riscfruit/Pico2-Expansion-Card/README.md

# FramePico2-Expansion-Card
An expansion card for Framework laptops and any other hardware, based on RP2354

### Gallery
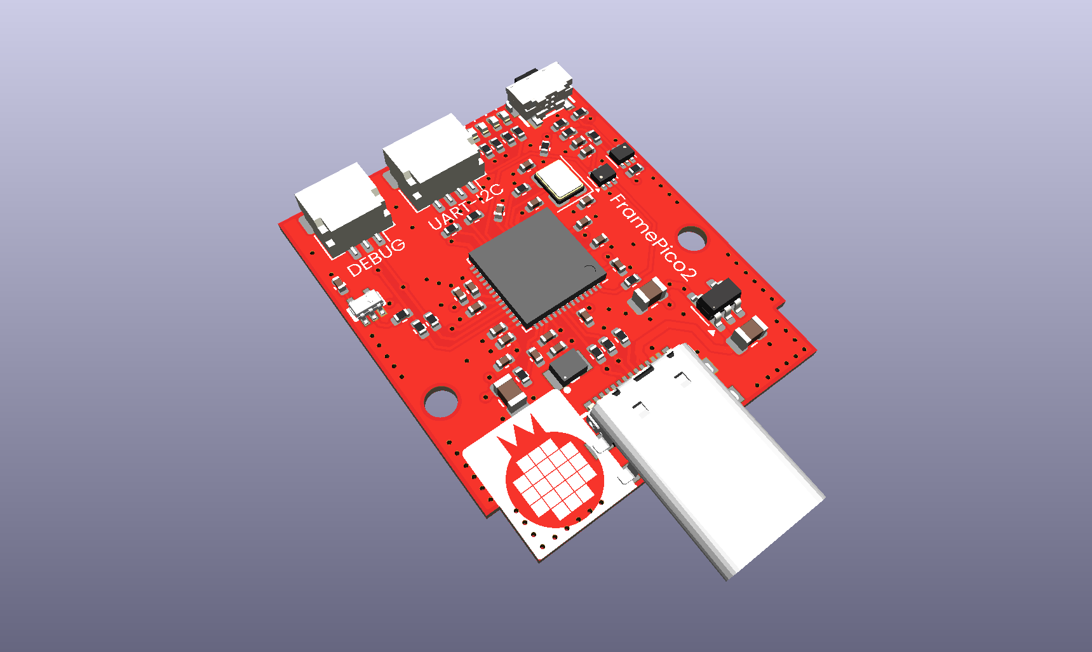
[picture p1: images/pico2-expansion-card-front.png]
Front

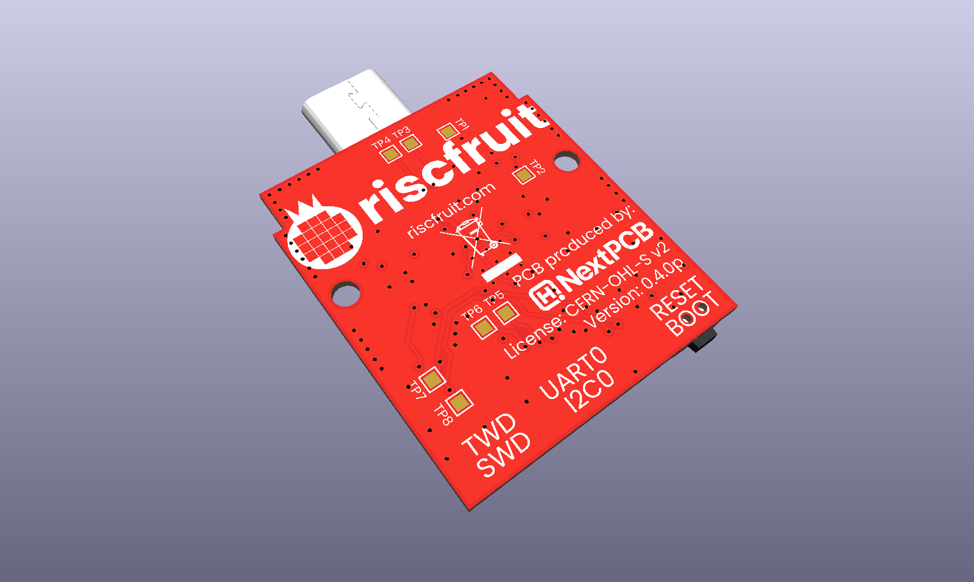
[picture p2: images/pico2-expansion-card-back.png]
Back
