riscfruit/Pico2-Expansion-Card/pcb/production/bom.csv

Designator | Package / Footprint | Qty | Value | LCSC Part # | MPN
C1, C20, C3, C5 | 402 | 4 | 4.7uF | C23733 | CL05A475MP5NRNC (Samsung)
C10, C11, C12, C13, C14, C17, C18, C22, C23, C25, C8, C9 | 402 | 12 | 100nF | C1525 | CL05B104KO5NNNC (Samsung)
C15, C16 | 402 | 2 | 15pF | C1548 | CL05C150JB5NNNC (Samsung)
C19, C2, C21 | 805 | 3 | 10uF | C15850 | CL21A106KPFNNNE (Samsung)
C24, C6 | 402 | 2 | 4u7 (4.7uF) | C23733 | CL05A475MP5NRNC (Samsung)
D1, D2, D3, D4 | 402 | 4 | LED | C2286 | KT-0402R (Hubei Kento, Red)*
J1 | JST_SH_SM03B... | 1 | JST_01x03 | C2919604 | 1.0K-BH-3PWB
J2 | JST_SH_SM04B... | 1 | JST_01x04 | C2919605 | 1.0K-BH-4PWB
L1 | IND-SMD_L2.0-W1.6... | 1 | 3.3uH | C42411119 | AOTA-B201610S3R3-101-T
P1 | USB-C-SMD_TYPE-C-31-G-10 | 1 | ~ | C5370430 | TYPE-C-31-G-10 (Korean Hroparts)
Q1, Q2 | SOT-563 | 2 | EM6K6 | C41354823 | SP2002KDTL
R1 | 402 | 1 | 33Ω | C25092 | 0402WGF3300TCE (UNI-ROYAL)
R10, R16 | 402 | 2 | 10KΩ | C25744 | 0402WGF1002TCE (UNI-ROYAL)
R11, R13, R14 | 402 | 3 | 51KΩ | C25794 | 0402WGF5102TCE (UNI-ROYAL)
R12, R5, R7 | 402 | 3 | 5K1 (5.1K) | C25905 | 0402WGF5101TCE (UNI-ROYAL)
R15 | 402 | 1 | 1KΩ | C11702 | 0402WGF1001TCE (UNI-ROYAL)
R17, R18, R19 | 402 | 3 | 100Ω | C25076 | 0402WGF1000TCE (UNI-ROYAL)
R2, R3 | 402 | 2 | 27Ω | C25100 | 0402WGF2700TCE (UNI-ROYAL)
R20, R21, R22, R23 | 402 | 4 | 470Ω | C25117 | 0402WGF4700TCE (UNI-ROYAL)
R4 | 402 | 1 | 5.1kΩ | C25905 | 0402WGF5101TCE (UNI-ROYAL)***
R8 | 402 | 1 | 1kΩ | C11702 | 0402WGF1001TCE (UNI-ROYAL)***
SW1 | BUTTON-SW-SMD_2P-TS24CA | 1 | SW_Push | C393942 | TS24CA (SHOU HAN)
TP1, TP2, TP3, TP4, TP5, TP6, TP7, TP8 | TestPoint_Pad_1.0x1.0mm | 8 | TestPoint | DNP | None (PCB pads only)
U1 | SOT-353 | 1 | ~ | C51939622 | TP74AUP1T17C5 (TECH PUBLIC)
U2 | RP2350-QFN-60... | 1 | RP2354A | C41378174 | RP2354A (Raspberry Pi)
U4 | SOT-23-5 | 1 | AP2127K-3.3 | C54845 | AP2127K-3.3TRG1 (Diodes Inc.)
Y1 | Crystal_SMD_3225... | 1 | ABM8-272-T3 | (Search) | ABM8-272-T3 (Abracon)
