riscfruit/Pico2-Expansion-Card/pcb/3D/RP2354A.stp

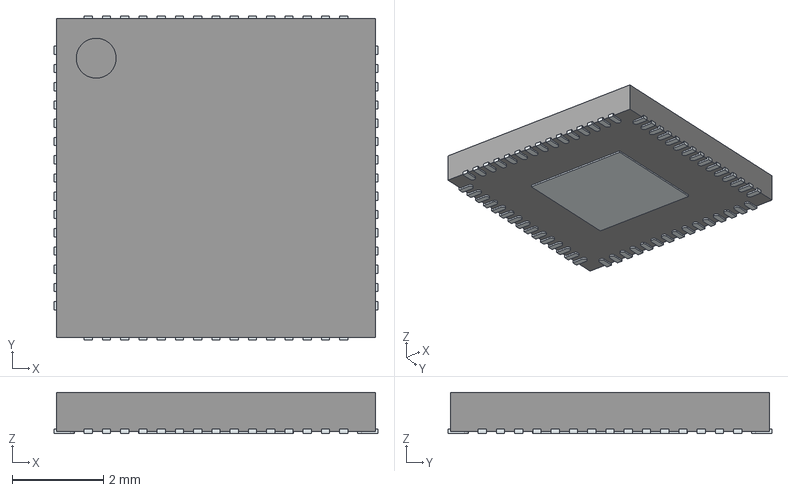
[picture p3: CAD file, 2026-10-31]
pcb/3D/RP2354A.stp
7.10 x 7.10 x 0.9 mm
ThermalPin
PinsArrayLR
PinsArrayTB
