riscfruit/Pico2-Expansion-Card/pcb/pico2model.step

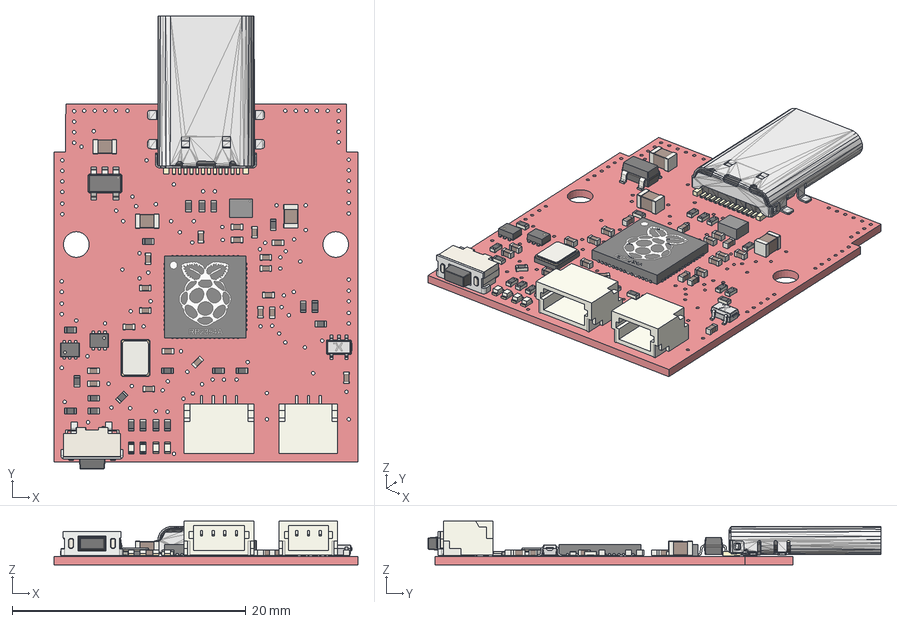
[picture p4: CAD file, 2026-10-31]
pcb/pico2model.step
26.0 x 38.7 x 3.75 mm
C_0402_1005Metric x 20
R_0402_1005Metric x 21
RP2354A
LED_0402_1005Metric x 4
Crystal_SMD_3225-4Pin_3.2x2.5mm
C_0805_2012Metric x 3
JST_SH_SM04B-SRSS-TB_1x04-1MP_P1.00mm_Horizontal
SOT-563 x 2
SOT353-1 Lower body
SOT353-1 Lead x 5
SOT353-1 Upper body
xiaobeibei_body
xiaobeibei_cap
xiaobeibei_plate
xiaobeibei_pin x 2
JST_SH_SM03B-SRSS-TB_1x03-1MP_P1.00mm_Horizontal
AOTA-B201610S3R3-101-T
SOT-23-5
C-UTC009
pico2-expansion-card_PCB
