riscfruit/Pico2-Expansion-Card/pcb/3D/C-UTC009.step

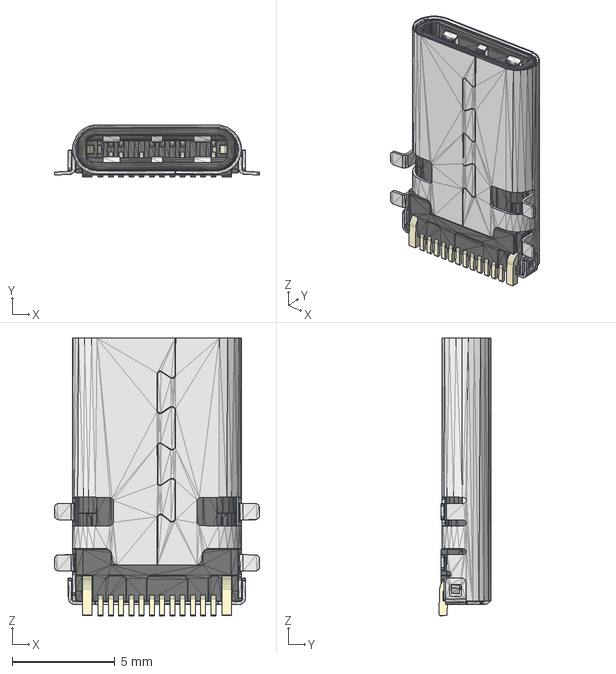
[picture p5: CAD file, 2026-09-14]
pcb/3D/C-UTC009.step
9.99 x 2.55 x 13.5 mm
