riscfruit/Pico2-Expansion-Card/pcb/3D/TYPE-C-31-G-10.step

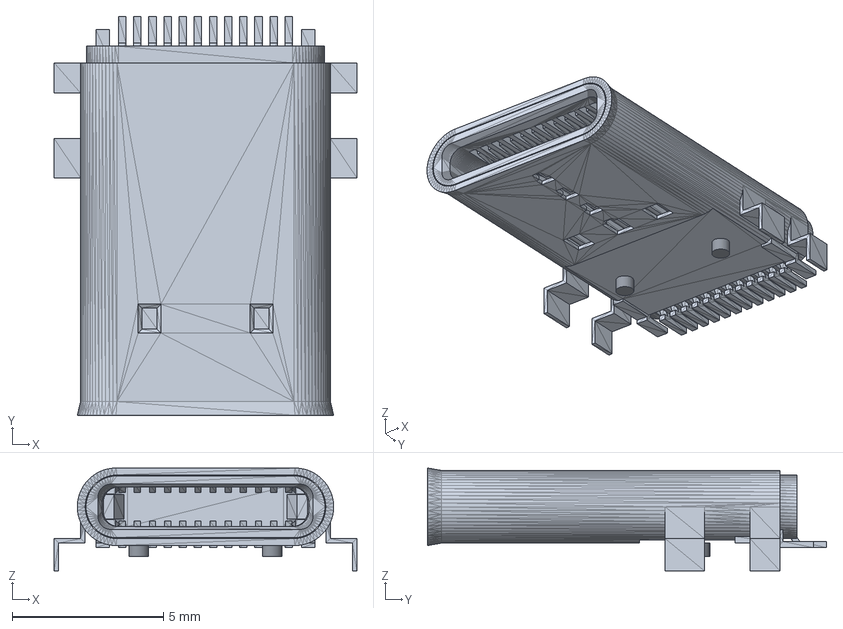
[picture p6: CAD file, 2026-09-13]
pcb/3D/TYPE-C-31-G-10.step
10.0 x 13.2 x 3.40 mm
STEP translator 7.5 1.1
STEP translator 7.5 1.2
STEP translator 7.5 1.3
STEP translator 7.5 1.4
STEP translator 7.5 1.5
STEP translator 7.5 1.6
STEP translator 7.5 1.7
STEP translator 7.5 1.8
STEP translator 7.5 1.9
STEP translator 7.5 1.10
STEP translator 7.5 1.11
STEP translator 7.5 1.12
STEP translator 7.5 1.13
STEP translator 7.5 1.14
STEP translator 7.5 1.15
STEP translator 7.5 1.16
STEP translator 7.5 1.17
STEP translator 7.5 1.18
STEP translator 7.5 1.19
STEP translator 7.5 1.20
STEP translator 7.5 1.21
STEP translator 7.5 1.22
STEP translator 7.5 1.23
