riscfruit/Pico2-Expansion-Card/pcb/3D/Korean Hroparts Elec TYPE-C-31-G-10.stp

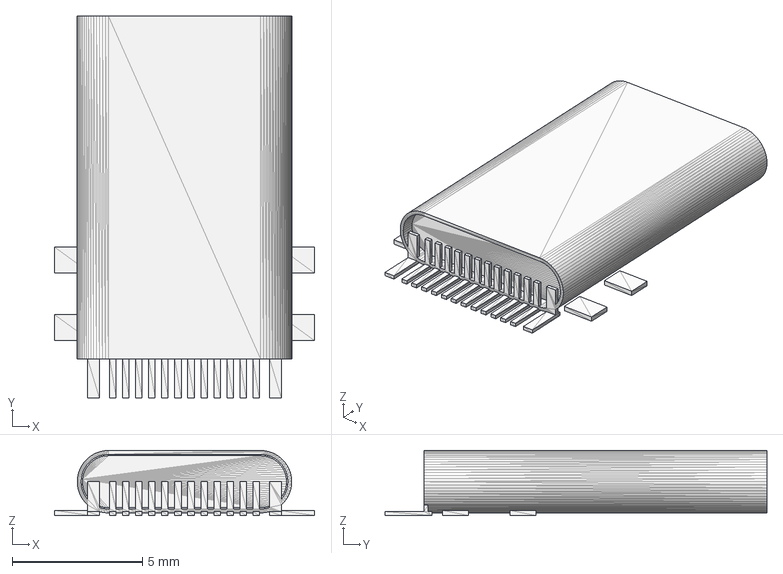
[picture p7: CAD file, 2026-09-13]
pcb/3D/Korean Hroparts Elec TYPE-C-31-G-10.stp
10.0 x 14.7 x 2.50 mm
