riscfruit/Pico2-Expansion-Card/pcb/3D/SHOU HAN TS36CA-0.6_v1.step

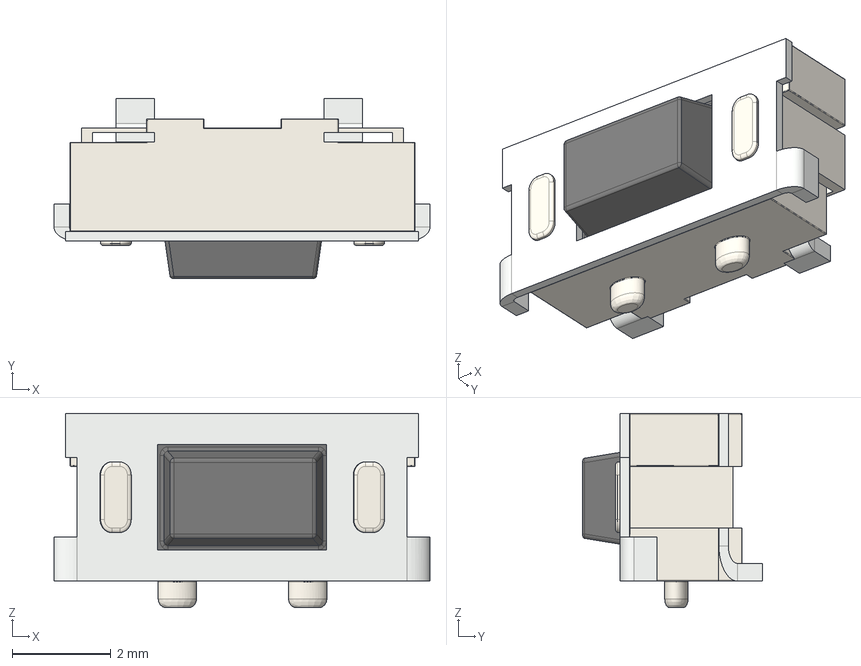
[picture p8: CAD file, 2026-09-13]
pcb/3D/SHOU HAN TS36CA-0.6_v1.step
7.60 x 3.64 x 3.93 mm
xiaobeibei_body
xiaobeibei_cap
xiaobeibei_plate
xiaobeibei_pin x 2
