riscfruit/Pico2-Expansion-Card/(list of files, cad)

Other CAD files:
pcb/.step
