riscfruit/Pico2-Expansion-Card/pcb/pico2-expansion-card.kicad_pcb

## KiCad design pcb/pico2-expansion-card.kicad_pcb (2026-11-06)

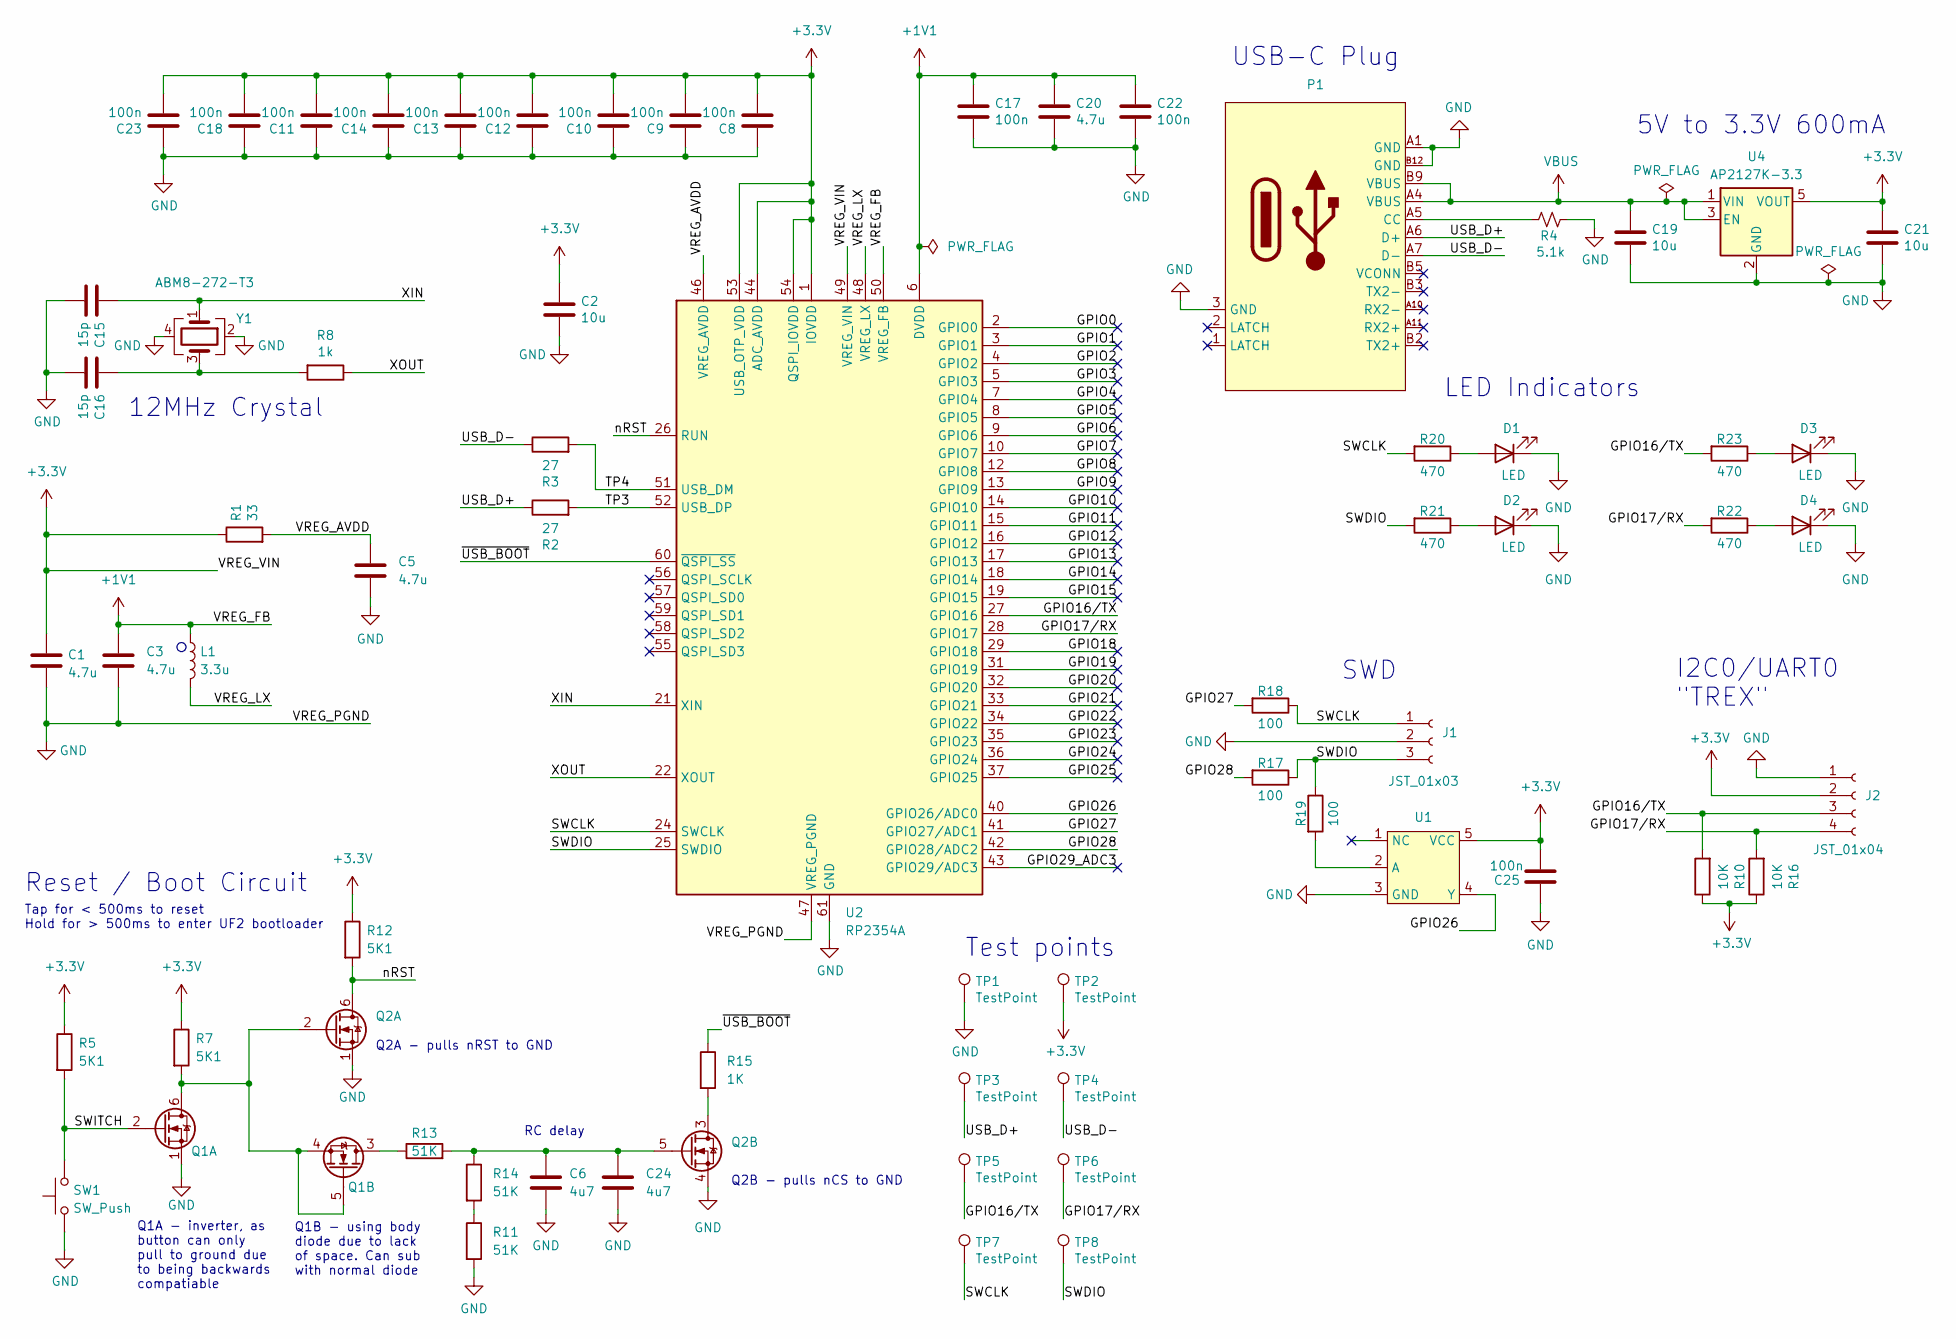
[picture p9: schematic pico2-expansion-card.kicad_sch, Pico2 Expansion Card]

Parts:
C1, C3: 4.7u; C_0402_1005Metric_small_pads
C2, C19, C21: 10u; C_0805_2012Metric
C5, C20: 4.7u; C_0402_1005Metric
C6, C24: 4u7; C_0402_1005Metric; MPN CL05A475MP5NRNC; JLC Basic Y
C8, C9, C10, C11, C12, C13, C14, C17, C18, C22, C23, C25: 100n; C_0402_1005Metric
C15, C16: 15p; C_0402_1005Metric
D1, D2, D3, D4: LED; LED_0402_1005Metric
J1: JST_01x03; JST_SH_SM03B-SRSS-TB_1x03-1MP_P1.00mm_Horizontal
J2: JST_01x04; JST_SH_SM04B-SRSS-TB_1x04-1MP_P1.00mm_Horizontal
L1: 3.3u; IND-SMD_L2.0-W1.6_AOTA-B201610S3R3-101-T
P1: USB-C-SMD_TYPE-C-31-G-10
Q1, Q2: EM6K6; SOT-563; MPN 2N7002V; JLC Basic N
R1: 33; R_0402_1005Metric
R2, R3: 27; R_0402_1005Metric
R4: 5.1k; R_0402_1005Metric
R5, R7, R12: 5K1; R_0402_1005Metric; MPN 0402WGF5101TCE; LCSC C25905
R8: 1k; R_0402_1005Metric
R10, R16: 10K; R_0402_1005Metric
R11, R13, R14: 51K; R_0402_1005Metric; MPN 0402WGF5102TCE; JLC Basic Y
R15: 1K; R_0402_1005Metric; MPN 0402WGF1001TCE; LCSC C11702
R17, R18, R19: 100; R_0402_1005Metric
R20, R21, R22, R23: 470; R_0402_1005Metric
SW1: SW_Push; BUTTON-SW-SMD_2P-TS24CA
TP1, TP2, TP3, TP4, TP5, TP6, TP7, TP8: TestPoint; TestPoint_Pad_1.0x1.0mm
U1: TECH PUBLIC TP74AUP1T17C5
U2: RP2354A; RP2350-QFN-60-1EP_7x7_P0.4mm_EP3.4x3.4mm_ThermalVias
U4: AP2127K-3.3; SOT-23-5
Y1: ABM8-272-T3; Crystal_SMD_3225-4Pin_3.2x2.5mm

Connections:
+1V1: C3.1, C17.1, C20.1, C22.1, L1.1, U2.6 (DVDD), U2.23 (DVDD), U2.39 (DVDD), U2.50 (VREG_FB)
+3.3V: C1.1, C2.1, C8.2, C9.2, C10.2, C11.2, C12.2, C13.2, C14.2, C18.2, C21.1, C23.2, J2.2, R1.1, R5.1, R7.1, R10.1, R12.1, R16.1, TP2.1 (1_1), U2.1 (IOVDD), U2.11 (IOVDD), U2.20 (IOVDD), U2.30 (IOVDD), U2.38 (IOVDD), U2.44 (ADC_AVDD), U2.45 (IOVDD), U2.49 (VREG_VIN), U2.53 (USB_OTP_VDD), U2.54 (QSPI_IOVDD), U4.5 (VOUT)
/GPIO0: U2.2 (GPIO0)
/GPIO1: U2.3 (GPIO1)
/GPIO2: U2.4 (GPIO2)
/GPIO3: U2.5 (GPIO3)
/GPIO4: U2.7 (GPIO4)
/GPIO5: U2.8 (GPIO5)
/GPIO6: U2.9 (GPIO6)
/GPIO7: U2.10 (GPIO7)
/GPIO8: U2.12 (GPIO8)
/GPIO9: U2.13 (GPIO9)
/GPIO10: U2.14 (GPIO10)
/GPIO11: U2.15 (GPIO11)
/GPIO12: U2.16 (GPIO12)
/GPIO13: U2.17 (GPIO13)
/GPIO14: U2.18 (GPIO14)
/GPIO15: U2.19 (GPIO15)
/GPIO16/TX: J2.3, R10.2, R23.2, TP5.1 (1_1), U2.27 (GPIO16)
/GPIO17/RX: J2.4, R16.2, R22.2, TP6.1 (1_1), U2.28 (GPIO17)
/GPIO18: U2.29 (GPIO18)
/GPIO19: U2.31 (GPIO19)
/GPIO20: U2.32 (GPIO20)
/GPIO21: U2.33 (GPIO21)
/GPIO22: U2.34 (GPIO22)
/GPIO23: U2.35 (GPIO23)
/GPIO24: U2.36 (GPIO24)
/GPIO25: U2.37 (GPIO25)
/GPIO26: U1.4 (Y), U2.40 (GPIO26/ADC0)
/GPIO27: R18.2, U2.41 (GPIO27/ADC1)
/GPIO28: R17.2, U2.42 (GPIO28/ADC2)
/GPIO29_ADC3: U2.43 (GPIO29/ADC3)
/SWCLK: J1.1, R18.1, R20.2, TP7.1 (1_1), U2.24 (SWCLK)
/SWDIO: J1.3, R17.1, R19.1, R21.2, TP8.1 (1_1), U2.25 (SWDIO)
/SWITCH: Q1.2 (G), R5.2, SW1.2
/TP3: R2.2, U2.52 (USB_DP)
/TP4: R3.2, U2.51 (USB_DM)
/USB_D+: P1.A6 (D+), R2.1, TP3.1 (1_1)
/USB_D-: P1.A7 (D-), R3.1, TP4.1 (1_1)
/VREG_AVDD: C5.1, R1.2, U2.46 (VREG_AVDD)
/VREG_LX: L1.2, U2.48 (VREG_LX)
/XIN: C15.1, U2.21 (XIN), Y1.1
/XOUT: R8.1, U2.22 (XOUT)
/nRST: Q2.6 (D), R12.2, U2.26 (RUN)
/~USB_BOOT: R15.1, U2.60 (~QSPI_SS)
GND: C1.2, C2.2, C3.2, C5.2, C6.2, C8.1, C9.1, C10.1, C11.1, C12.1, C13.1, C14.1, C15.2, C16.2, C17.2, C18.1, C19.2, C20.2, C21.2, C22.2, C23.1, C24.2, C25.1, D1.1 (K), D2.1 (K), D3.1 (K), D4.1 (K), J1.2, J2.1, P1.3 (GND), P1.A1 (GND), P1.B12 (GND), Q1.1 (S), Q2.1 (S), Q2.4 (S), R4.2, R11.2, SW1.1, TP1.1 (1_1), U1.3 (GND), U2.47 (VREG_PGND), U2.61 (GND), U4.2 (GND), Y1.2, Y1.4
unnamed: C16.1, R8.2, Y1.3
unnamed: D1.2 (A), R20.1
unnamed: D2.2 (A), R21.1
unnamed: D3.2 (A), R23.1
unnamed: D4.2 (A), R22.1
unnamed: P1.A5 (CC), R4.1
unnamed: Q1.4 (S), Q1.5 (G), Q1.6 (D), Q2.2 (G), R7.2
unnamed: Q1.3 (D), R13.1
unnamed: Q2.3 (D), R15.2
unnamed: C6.1, C24.1, Q2.5 (G), R13.2, R14.1
unnamed: R11.1, R14.2
unnamed: R19.2, U1.2 (A)
unnamed: C25.2, U1.5 (VCC)
VBUS: C19.1, P1.A4 (VBUS), P1.B9 (VBUS), U4.1 (VIN), U4.3 (EN)

Notes on the sheet:
Q2B - pulls nCS to GND
Tap for < 500ms to reset Hold for > 500ms to enter UF2 bootloader
LED Indicators
USB-C Plug
Q1B - using body diode due to lack of space. Can sub with normal diode
12MHz Crystal
Reset / Boot Circuit
Q1A - inverter, as button can only pull to ground due to being backwards compatiable
5V to 3.3V 600mA
I2C0/UART0 "TREX"
Test points
SWD
RC delay
Q2A - pulls nRST to GND

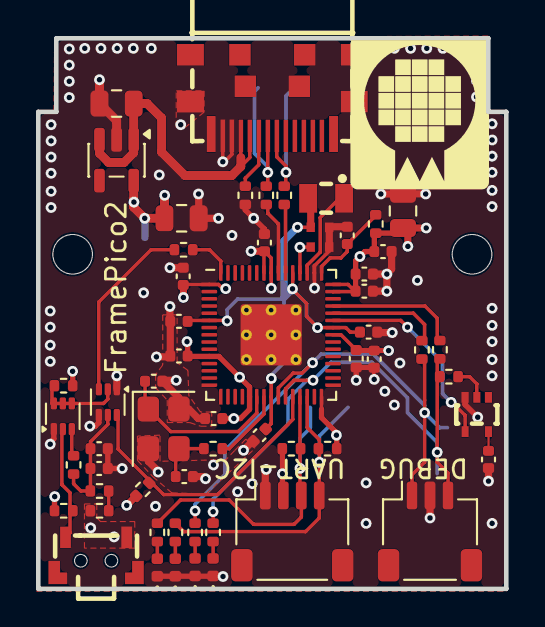
[picture p10: board pico2-expansion-card.kicad_pcb from above]

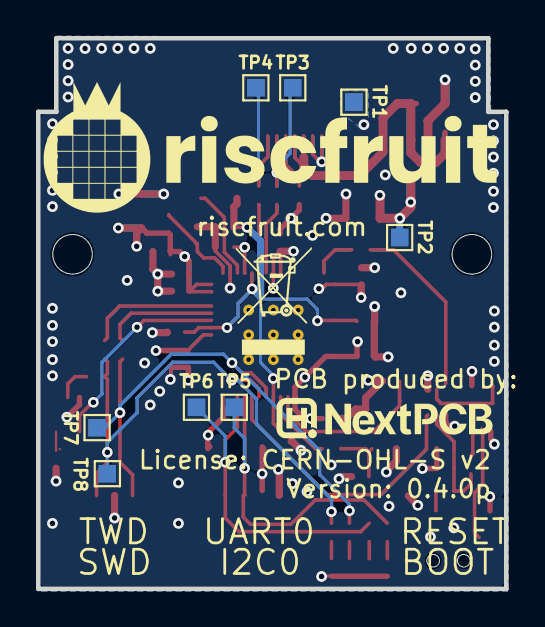
[picture p11: board pico2-expansion-card.kicad_pcb from below]

Board: 4 copper layers, 26.0 x 30.6 mm, 69 parts (8 on the bottom side), 35 nets.

Other parts of the board:
H1, H1#2: MountingHole; MountingHole_2.2mm_M2
