riscfruit/Pico2-Expansion-Card/(commit log)

2026-08-06 finish schematics, assign footprints and start pcb design
    [pico2-expansion-card.kicad_pcb, pico2-expansion-card.kicad_sch]
2026-08-10 edit schematic, change type-c, add single button bootsel reset, make pcb
    [pico2-expansion-card.kicad_pcb, pico2-expansion-card.kicad_sch]
2026-08-11 finish v0.1.0p prototype design
    [pico2-expansion-card-B_Cu.gbr, pico2-expansion-card-B_Mask.gbr, pico2-expansion-card-B_Paste.gbr, pico2-expansion-card-B_Silkscreen.gbr, pico2-expansion-card-Edge_Cuts.gbr, pico2-expansion-card-F_Cu.gbr, pico2-expansion-card-F_Mask.gbr, pico2-expansion-card-F_Paste.gbr]
2026-08-11 minor cosmetic changes in schematics and footprints
    [pico2-expansion-card.kicad_pcb, pico2-expansion-card.kicad_sch]
2026-08-11 gerber and centroid
    [pico2-expansion-card-B_Cu.gbr, pico2-expansion-card-B_Mask.gbr, pico2-expansion-card-B_Paste.gbr, pico2-expansion-card-B_Silkscreen.gbr, pico2-expansion-card-Edge_Cuts.gbr, pico2-expansion-card-F_Cu.gbr, pico2-expansion-card-F_Mask.gbr, pico2-expansion-card-F_Paste.gbr]
2026-08-12 cosmetic changes
    [pico2-expansion-card-B_Cu.gbr, pico2-expansion-card-B_Mask.gbr, pico2-expansion-card-B_Paste.gbr, pico2-expansion-card-B_Silkscreen.gbr, pico2-expansion-card-Edge_Cuts.gbr, pico2-expansion-card-F_Cu.gbr, pico2-expansion-card-F_Mask.gbr, pico2-expansion-card-F_Paste.gbr]
2026-08-12 cosmetic minor changes
    [pico2-expansion-card.csv, pico2-expansion-card.kicad_pcb, pico2-expansion-card.kicad_sch, pico2-expansion-card.xlsx]
2026-08-12 fix connections
    [pico2-expansion-card-B_Cu.gbr, pico2-expansion-card-B_Mask.gbr, pico2-expansion-card-B_Paste.gbr, pico2-expansion-card-B_Silkscreen.gbr, pico2-expansion-card-Edge_Cuts.gbr, pico2-expansion-card-F_Cu.gbr, pico2-expansion-card-F_Mask.gbr, pico2-expansion-card-F_Paste.gbr]
2026-08-12 fix missing i2c pull up
    [pico2-expansion-card-B_Cu.gbr, pico2-expansion-card-B_Mask.gbr, pico2-expansion-card-B_Paste.gbr, pico2-expansion-card-B_Silkscreen.gbr, pico2-expansion-card-Edge_Cuts.gbr, pico2-expansion-card-F_Cu.gbr, pico2-expansion-card-F_Mask.gbr, pico2-expansion-card-F_Paste.gbr]
2026-08-12 edit pcb more, polish it
    [pico2-expansion-card-B_Cu.gbr, pico2-expansion-card-B_Mask.gbr, pico2-expansion-card-B_Paste.gbr, pico2-expansion-card-B_Silkscreen.gbr, pico2-expansion-card-Edge_Cuts.gbr, pico2-expansion-card-F_Cu.gbr, pico2-expansion-card-F_Mask.gbr, pico2-expansion-card-F_Paste.gbr]
2026-08-12 update BOM
    [pico2-expansion-card-BOM.xlsx, pico2-expansion-card.xlsx]
2026-08-17 fix hole positions
    [pico2-expansion-card-B_Cu.gbr, pico2-expansion-card-B_Mask.gbr, pico2-expansion-card-B_Paste.gbr, pico2-expansion-card-B_Silkscreen.gbr, pico2-expansion-card-Edge_Cuts.gbr, pico2-expansion-card-F_Cu.gbr, pico2-expansion-card-F_Mask.gbr, pico2-expansion-card-F_Paste.gbr]
2026-08-17 minor cleanup after dfn check
    [pico2-expansion-card-B_Cu.gbr, pico2-expansion-card-B_Mask.gbr, pico2-expansion-card-B_Paste.gbr, pico2-expansion-card-B_Silkscreen.gbr, pico2-expansion-card-Edge_Cuts.gbr, pico2-expansion-card-F_Cu.gbr, pico2-expansion-card-F_Mask.gbr, pico2-expansion-card-F_Paste.gbr]
2026-08-21 fix false UART
    [pico2-expansion-card-BOM.xlsx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]
2026-09-03 update pcb, dd resistors to port 1
2026-09-04 edit placements, silkscreens
2026-09-09 update riscfruit logo silkscreen on back
2026-09-09 edit design, add silkscreen, make some lines thicker
2026-09-09 Complete version 0.4.0p: Switch to 4-layer, add LEDs
2026-09-10 edit power lines, put more via
2026-09-13 move components, add vias, pour gnd to signal layers and add 3d models
2026-09-13 update usb-c model and edit button proportions
2026-09-14 edit silkscreen, add more vias
2026-09-22 edit PCB, add more stitching vias, move vias away from pads
2026-09-22 edit PCB a bit more, move vias and some silkscreen
2026-09-23 edit copper clearance, edit silkscreen, move vias and testpoints
2026-11-06 change name to FramePico2 upon Mouser suggestion, edit pcb and readme
