riscfruit/Pico2-Expansion-Card/(notices)

Notices in the files:
pcb/pico2-expansion-card.kicad_sch:
License: CERN-OHL-S v2
